siddolo/3Dprinter-laser/3D-back.png

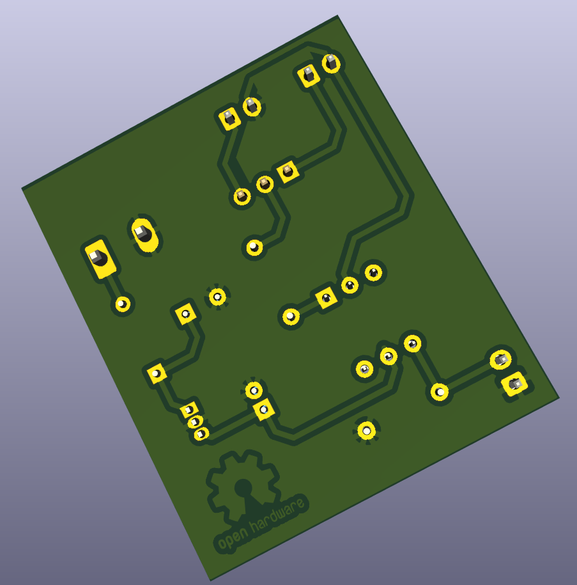
3D-back.png
