siddolo/3Dprinter-laser/schematics.png

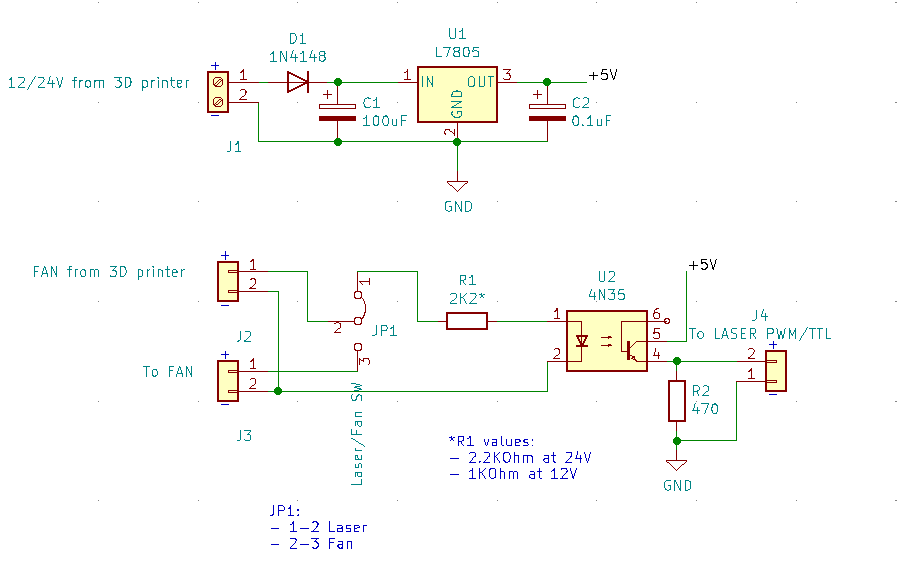
schematics.png
