siddolo/3Dprinter-laser/3Dprinter-laser.kicad_pcb

## KiCad design 3Dprinter-laser.kicad_pcb (2021-01-28)

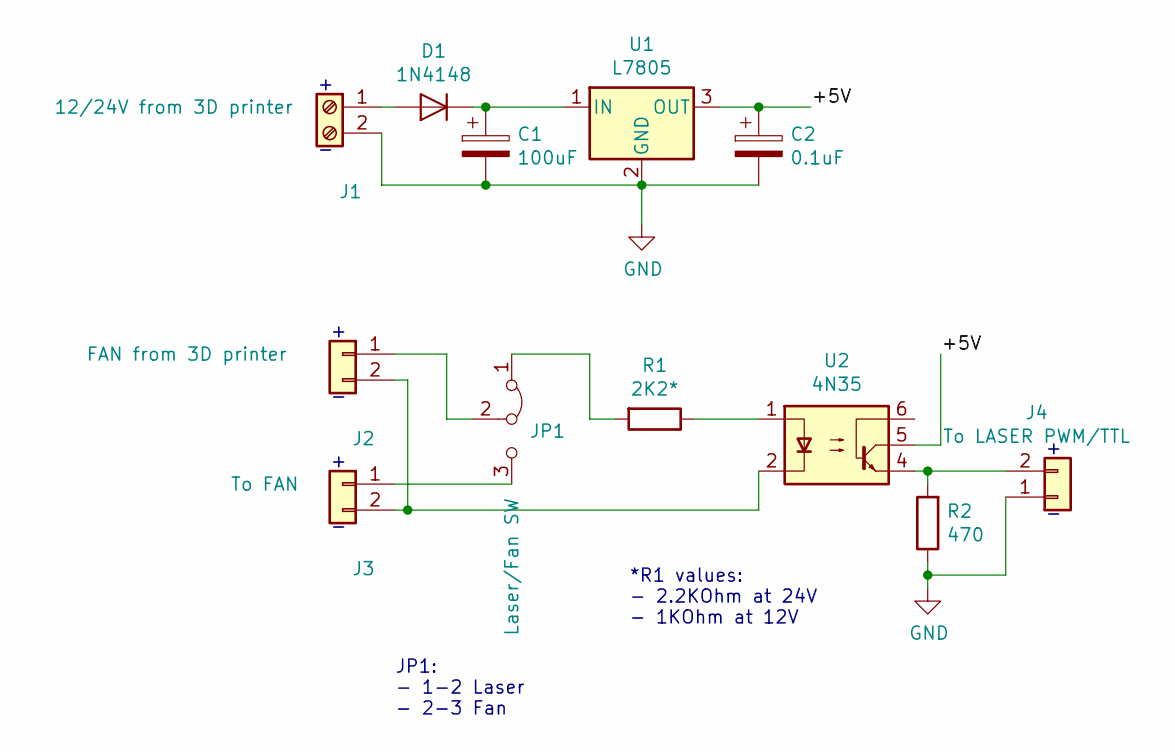
[picture p4: schematic 3Dprinter-laser.sch, 3D Printer 5V PWM/TTL Laser Adapter]

Parts:
C1: 100uF; CP_Radial_D8.0mm_P3.50mm
C2: 0.1uF; CP_Radial_D5.0mm_P2.00mm
D1: 1N4148; D_DO-34_SOD68_P7.62mm_Horizontal
J1: 12/24V from 3D printer; PhoenixContact_MSTBA_2,5_2-G_1x02_P5.00mm_Horizontal
J2: FAN from 3D printer; JST_XH_B02B-XH-A_1x02_P2.50mm_Vertical
J3: To FAN; JST_XH_B02B-XH-A_1x02_P2.50mm_Vertical
J4: To LASER PWM/TTL; JST_XH_B02B-XH-A_1x02_P2.50mm_Vertical
JP1: Laser/Fan SW; PinHeader_1x03_P2.54mm_Vertical
R1: 2K2*; R_Axial_DIN0207_L6.3mm_D2.5mm_P7.62mm_Horizontal
R2: 470; R_Axial_DIN0207_L6.3mm_D2.5mm_P7.62mm_Horizontal
U1: L7805; TO-92_Inline
U2: 4N35; DIP-6_W7.62mm

Connections:
/+5V: C2.1, U1.3 (OUT), U2.5
GND: C1.2, C2.2, J1.2, J4.1, R2.1, U1.2 (GND)
unnamed: C1.1, D1.1 (K), U1.1 (IN)
unnamed: D1.2 (A), J1.1
unnamed: J2.1, JP1.2 (C)
unnamed: J2.2, J3.2, U2.2
unnamed: J3.1, JP1.3 (B)
unnamed: J4.2, R2.2, U2.4
unnamed: JP1.1 (A), R1.2
unnamed: R1.1, U2.1

Notes on the sheet:
*R1 values: - 2.2KOhm at 24V - 1KOhm at 12V
JP1: - 1-2 Laser - 2-3 Fan

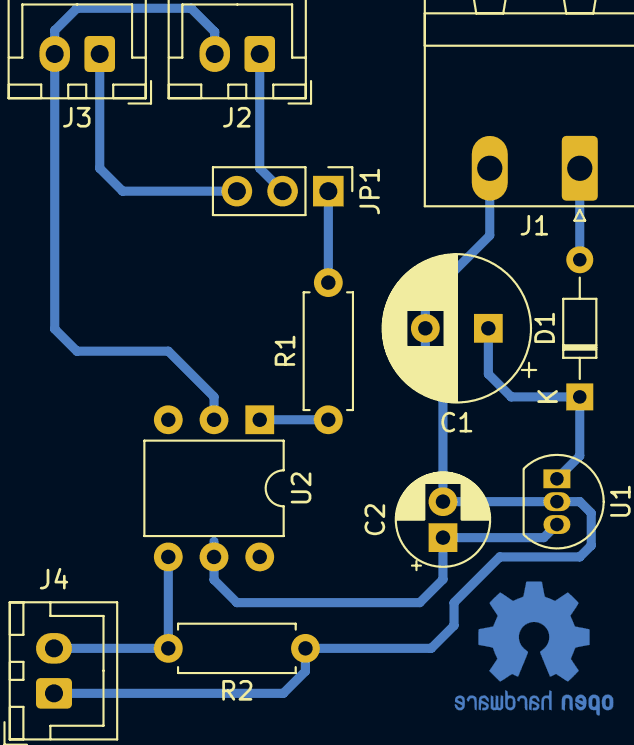
[picture p5: board 3Dprinter-laser.kicad_pcb from above]

Board: 2 copper layers, 12 parts (0 on the bottom side), 10 nets.
