siddolo/3Dprinter-laser/(threads)

Thread 1 (2019-08-06):

upload to OSHpark

sl1pkn07, 2019-08-06:
Hi. thanks for this wonderful project

i want craft the PCB throught OSHpark service

i can(with permission)/or you can upload the PCB to this service?

https://oshpark.com

greetings

siddolo, 2020-01-02:
yes, for sure

Haku73, 2021-01-27:
Hi,
I have a problem with my laser. When I plug it in, it always turn on. I checked and actually the PWM / TTL output modulates from 0 to 5V with the cooling fan. It's probably a problem with my laser [(this)](https://it.aliexpress.com/item/32367371022.html?spm=a2g0s.9042311.0.0.27424c4dlOAgxU). What could I feel? The same happens with the plotter on which it was mounted if I connect the USB power supply first. It may depend on the frequency of the TTL modulation?

Thanks
Andrea

siddolo, 2021-01-28:
Hi Andrea,

check the JP1 fix: https://github.com/siddolo/3Dprinter-laser/blob/master/schematics.png

Closed 2020-01-02.

Thread 2 (2021-01-28):

Problem with my laser

Haku73, 2021-01-28:
Hi Sid,
thanks for the project. I wanted to submit to you a problem that I had with my laser and that maybe it can be useful to others too. The laser is a 5.5W TTL 0-5V 0.25Khz modulation. When I connect the circuit, the laser turns on at maximum power and it is not possible to modulate it. I also tried to bypass JP1. I have checked and actually on the pin of TTL output port the status varies from 0 to 5V in accordance with the fan speed. The same problem of turning on at maximum power happens with the control circuit supplied (it is part of [this ](https://it.aliexpress.com/item/32367371022.html?spm=a2g0s.9042311.0.0.27424c4dlOAgxU)plotter) if I do not connect the USB first. Hope you can help me do some tests to make it work with your circuit.

Thanks
Andrea

Thread 3 (2021-06-04):

assembly issues

jbonn765, 2021-06-04:
Ive tried to upload to jlcpcb to have them assemble this board for me but i cant seem to find any of your components in their library. im having a hell of a time trying to get this board made. im sure you are a busy person but if you dont mind laying out some information that could help me get this built without the major headache ive had so far i would be very grateful.

thanks for your time
