siddolo/3Dprinter-laser/(commit log)

2019-02-16 3D printer laser adapter
    [3Dprinter-laser.kicad_pcb, 3Dprinter-laser.sch]
2021-01-28 fix JP1
    [3Dprinter-laser.kicad_pcb, 3Dprinter-laser.sch]
